4D-6429/Posedion-Project/README.md

# Posedion-Project

Katamaran1
