4D-6429/Posedion-Project/CAD/ORTA_Gövde.STEP

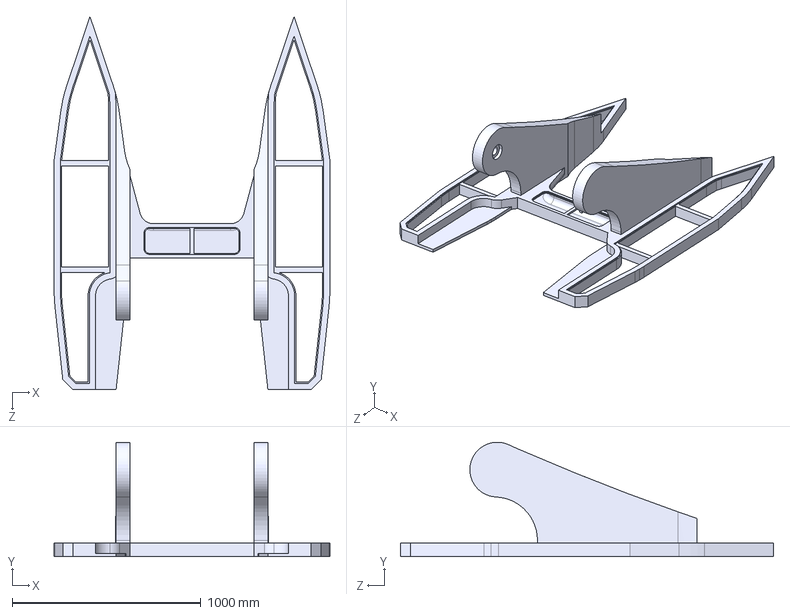
[picture p9: CAD file, 2025-03-03, last stored version]
CAD/ORTA_Gövde.STEP
1460.0 x 606.1 x 1975.0 mm
