4D-6429/Posedion-Project/CAD/Elektro_Kapak.STEP

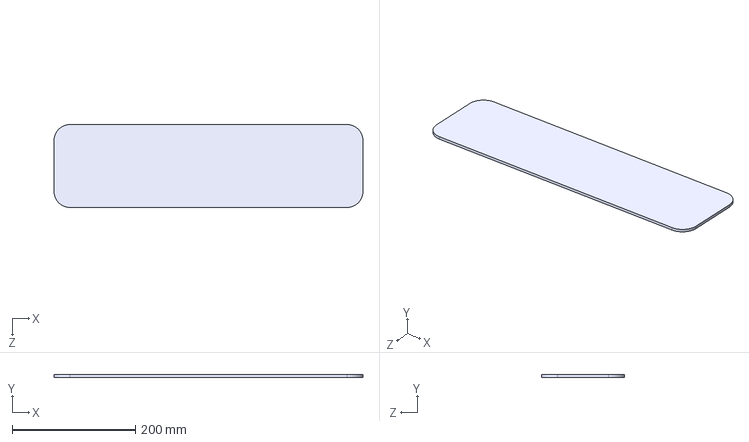
[picture p10: CAD file, 2025-03-03, last stored version]
CAD/Elektro_Kapak.STEP
501.1 x 4.38 x 134.5 mm
