4D-6429/Posedion-Project/CAD/#35 Half Link.STEP

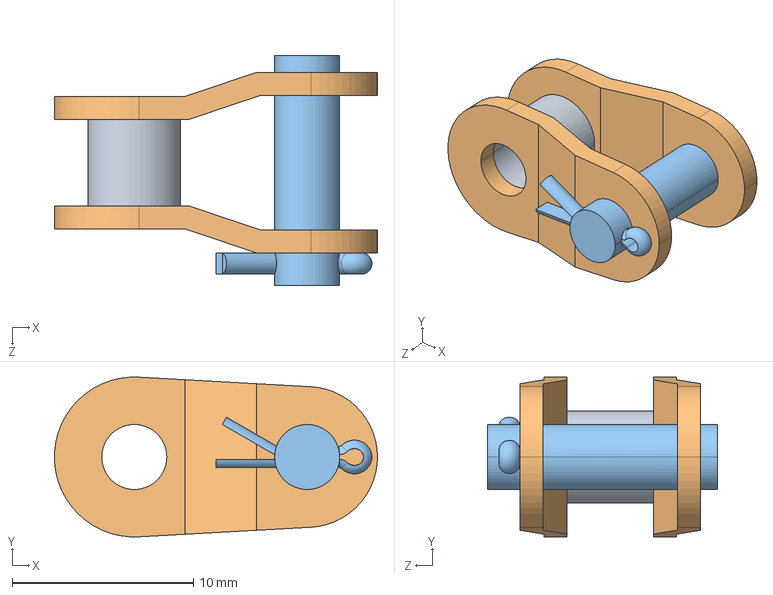
[picture p11: CAD file, 2025-03-03, last stored version]
CAD/#35 Half Link.STEP
17.8 x 8.80 x 12.7 mm
