4D-6429/Posedion-Project/CAD/Kare_Spacer.STEP

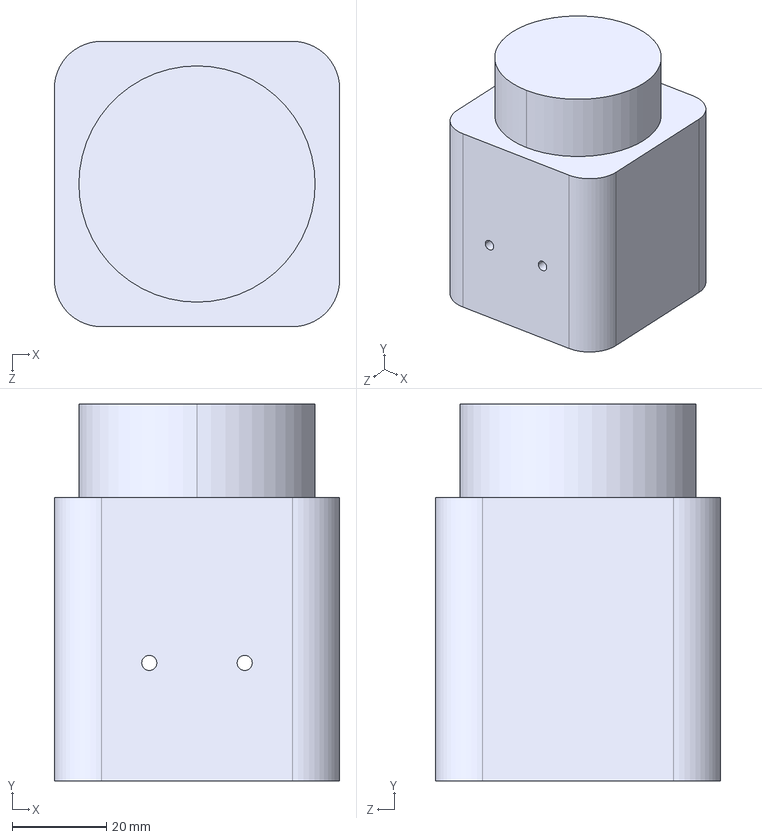
[picture p12: CAD file, 2025-03-03, last stored version]
CAD/Kare_Spacer.STEP
60.4 x 79.8 x 60.4 mm
