4D-6429/Posedion-Project/CAD/24_Torna.STEP

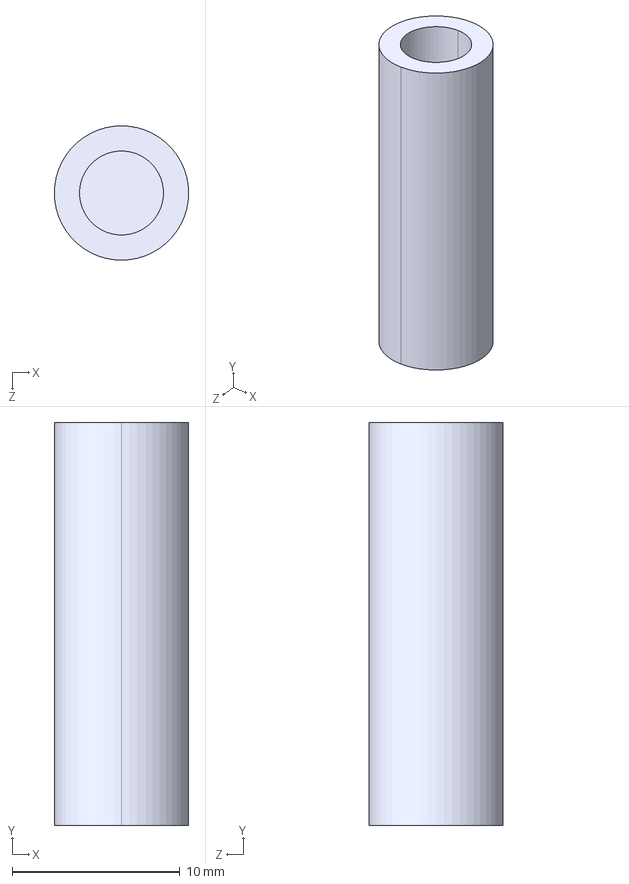
[picture p13: CAD file, 2025-03-03, last stored version]
CAD/24_Torna.STEP
8.00 x 24.0 x 8.00 mm
