4D-6429/Posedion-Project/CAD/Propeller.STEP

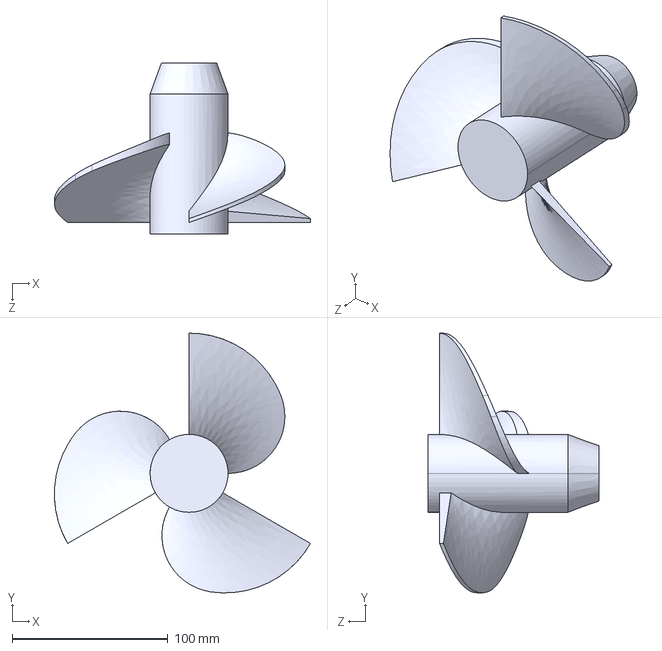
[picture p15: CAD file, 2025-03-03, last stored version]
CAD/Propeller.STEP
164.3 x 166.7 x 110.0 mm
