4D-6429/Posedion-Project/CAD/C-EC254SQ40Z12-POM.STEP

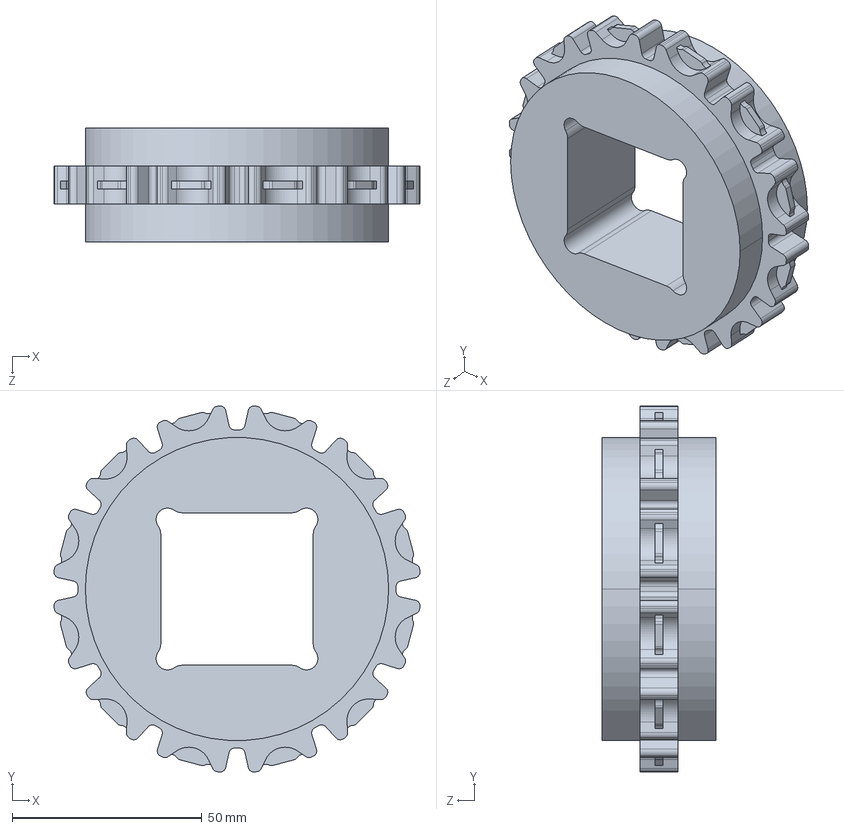
[picture p16: CAD file, 2025-03-03, last stored version]
CAD/C-EC254SQ40Z12-POM.STEP
96.6 x 96.6 x 30.0 mm
