4D-6429/Posedion-Project/CAD/HEX_Şaft-2in.STEP

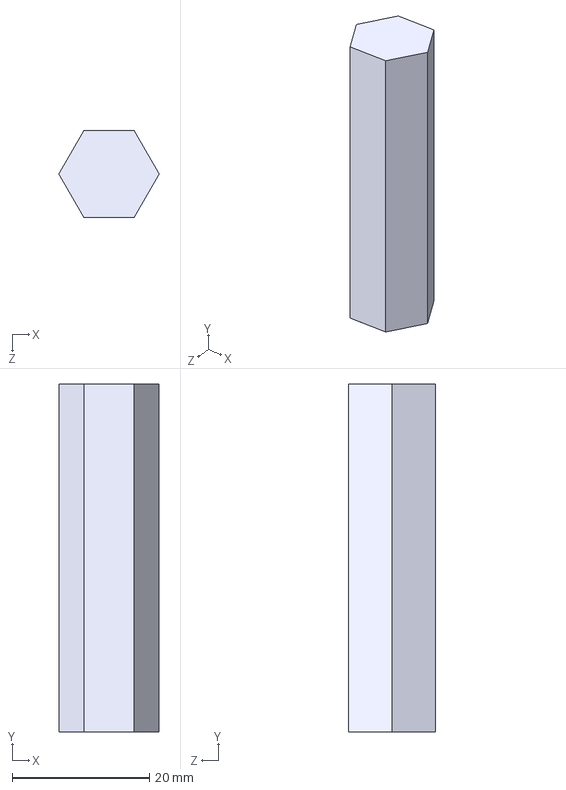
[picture p17: CAD file, 2025-03-03, last stored version]
CAD/HEX_Şaft-2in.STEP
14.7 x 50.8 x 12.7 mm
