4D-6429/Posedion-Project/CAD/Aşağı_Şaft.STEP

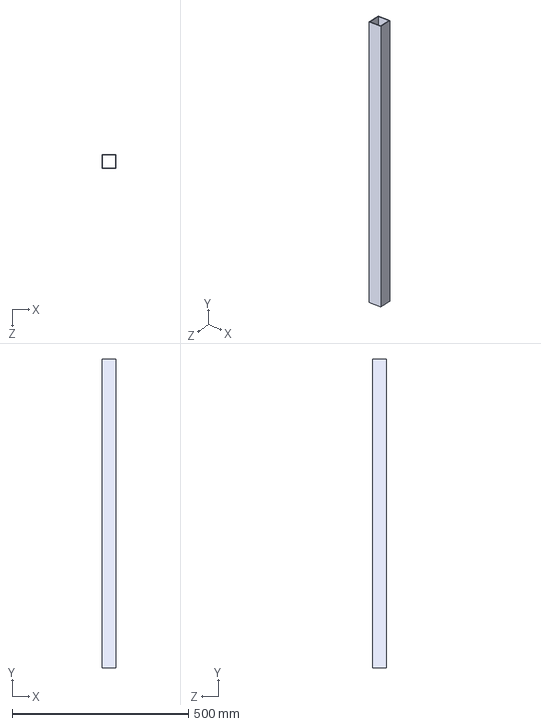
[picture p18: CAD file, 2025-03-03, last stored version]
CAD/Aşağı_Şaft.STEP
40.0 x 875.6 x 40.0 mm
