4D-6429/Posedion-Project/CAD/Kon_Güç.STEP

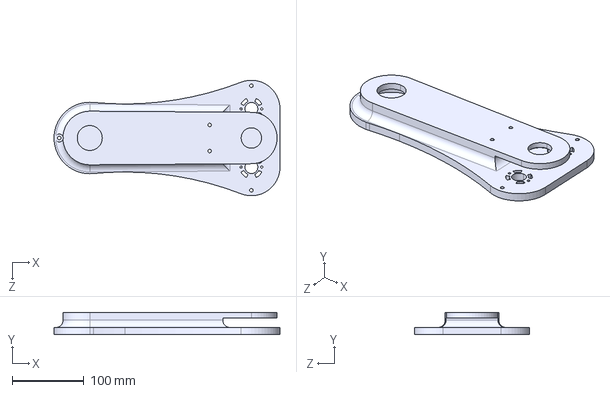
[picture p19: CAD file, 2025-03-03, last stored version]
CAD/Kon_Güç.STEP
316.1 x 30.9 x 161.4 mm
