4D-6429/Posedion-Project/CAD/Kapak.STEP

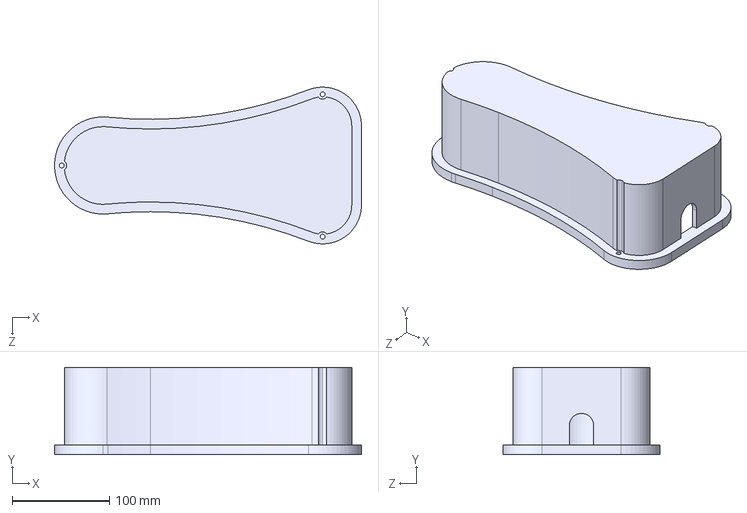
[picture p20: CAD file, 2025-03-03, last stored version]
CAD/Kapak.STEP
316.1 x 90.0 x 161.4 mm
