4D-6429/Posedion-Project/CAD/12t Aluminum Double Hub Sprocket (#35 Chain, 12 Hex Bore).step

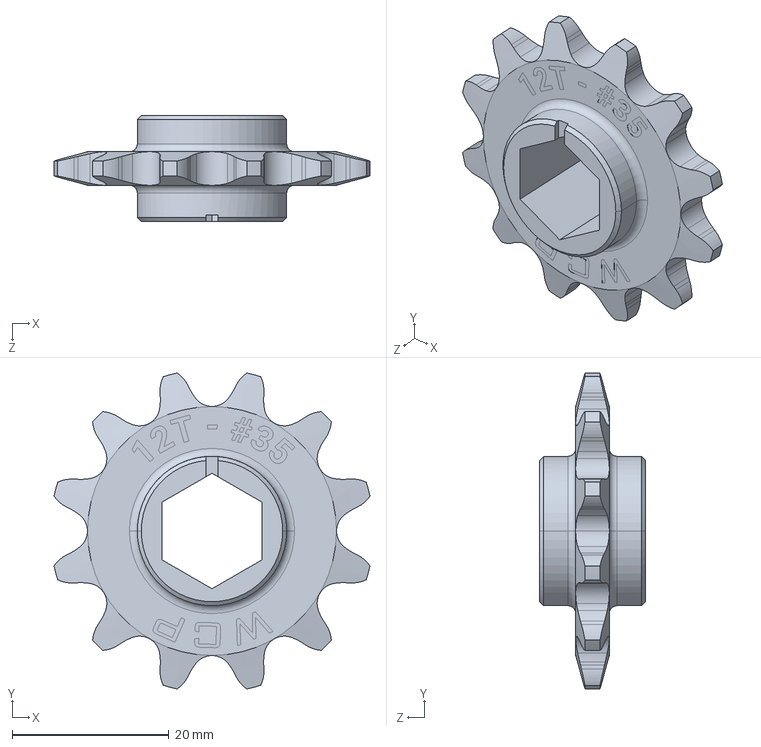
[picture p21: CAD file, 2025-03-03, last stored version]
CAD/12t Aluminum Double Hub Sprocket (#35 Chain, 12 Hex Bore).step
40.3 x 40.3 x 13.5 mm
