4D-6429/Posedion-Project/CAD/Hazne.STEP

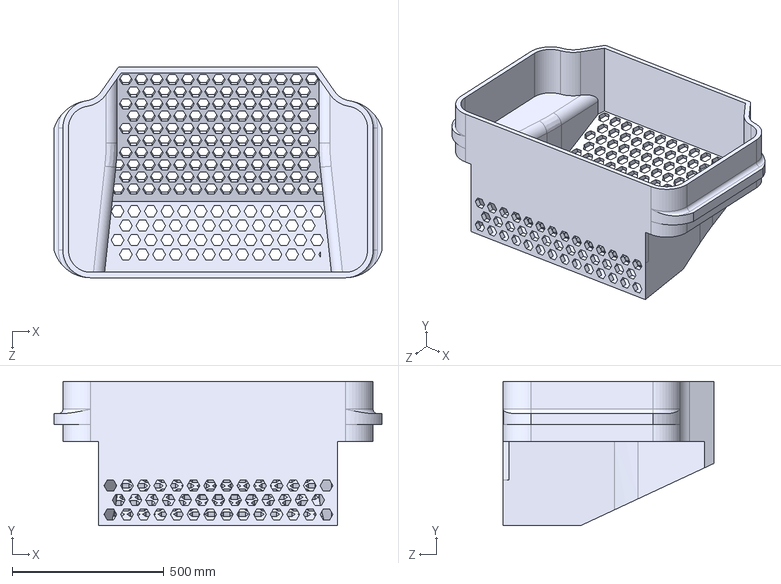
[picture p23: CAD file, 2025-03-03, last stored version]
CAD/Hazne.STEP
1080.4 x 474.5 x 693.5 mm
