4D-6429/Posedion-Project/CAD/PoliÜst.STEP

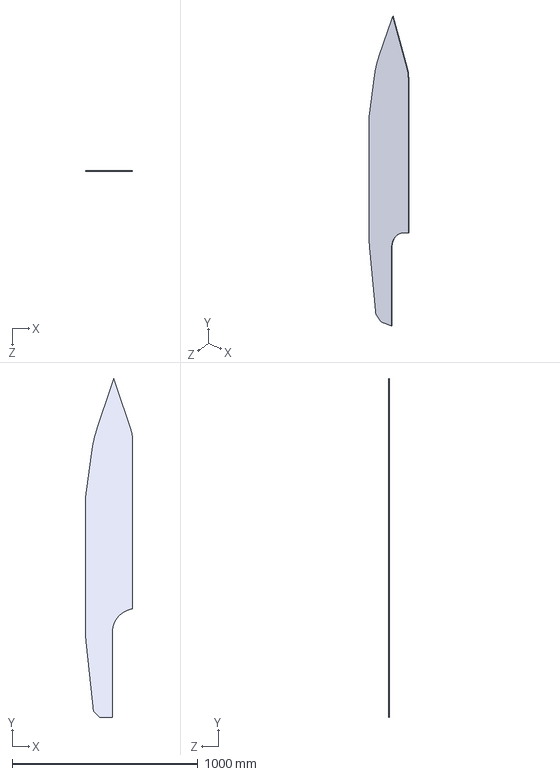
[picture p24: CAD file, 2025-03-03, last stored version]
CAD/PoliÜst.STEP
255.5 x 1824.0 x 4.38 mm
