4D-6429/Posedion-Project/CAD/0.5 hex çark 54t 20dp.STEP

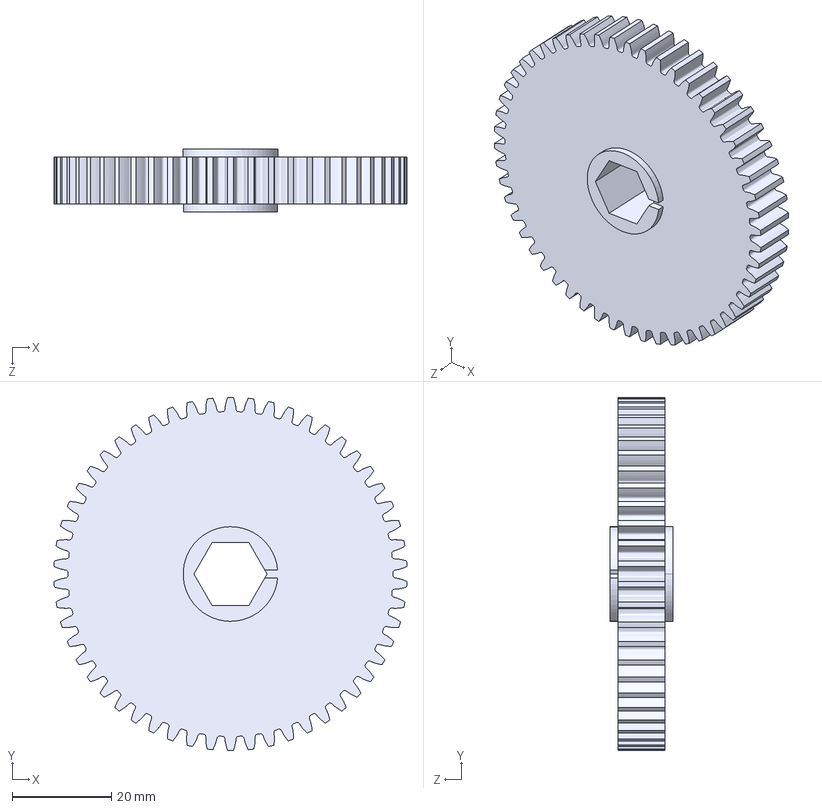
[picture p25: CAD file, 2025-03-03, last stored version]
CAD/0.5 hex çark 54t 20dp.STEP
71.1 x 71.1 x 12.6 mm
