4D-6429/Posedion-Project/CAD/10mmX111cm.STEP

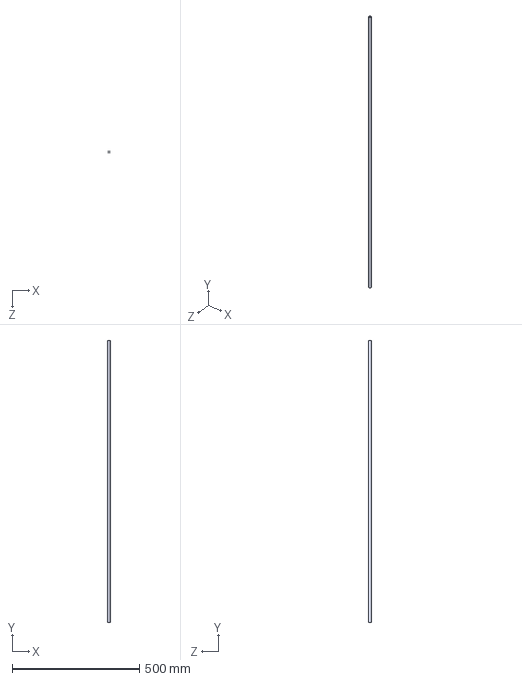
[picture p26: CAD file, 2025-03-03, last stored version]
CAD/10mmX111cm.STEP
10.0 x 1110.0 x 10.0 mm
