4D-6429/Posedion-Project/CAD/0.5 hex rulman.STEP

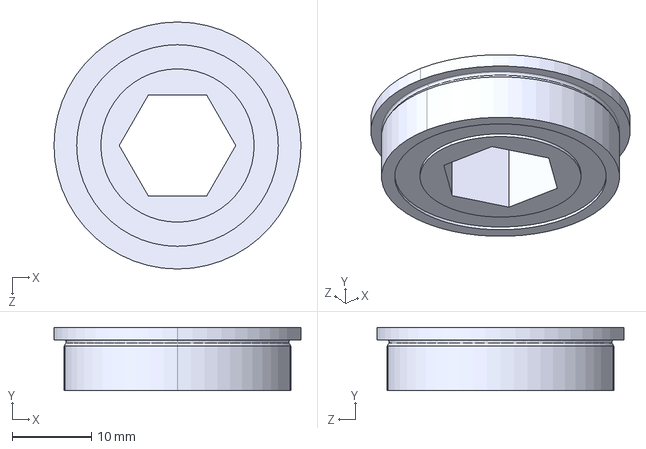
[picture p27: CAD file, 2025-03-03, last stored version]
CAD/0.5 hex rulman.STEP
31.1 x 7.94 x 31.1 mm
