4D-6429/Posedion-Project/CAD/50x90x20_Rulman.STEP

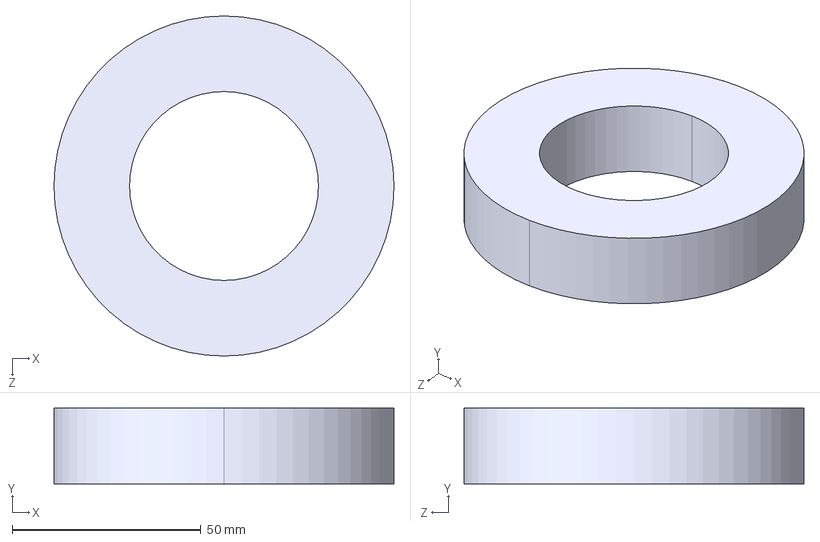
[picture p28: CAD file, 2025-03-03, last stored version]
CAD/50x90x20_Rulman.STEP
90.0 x 20.0 x 90.0 mm
