4D-6429/Posedion-Project/CAD/Spacer_5-19.STEP

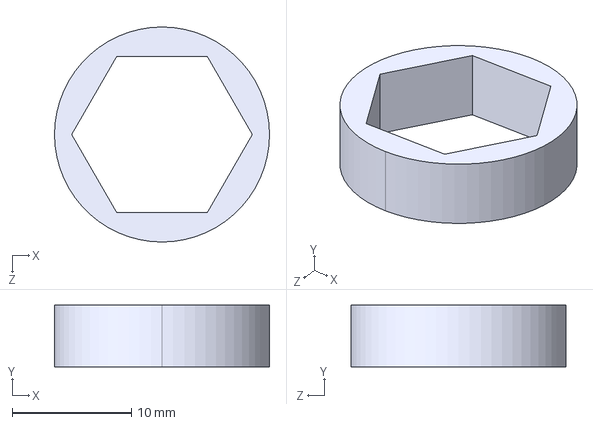
[picture p29: CAD file, 2025-03-03, last stored version]
CAD/Spacer_5-19.STEP
18.0 x 5.19 x 18.0 mm
