4D-6429/Posedion-Project/CAD/#35 Master Link.STEP

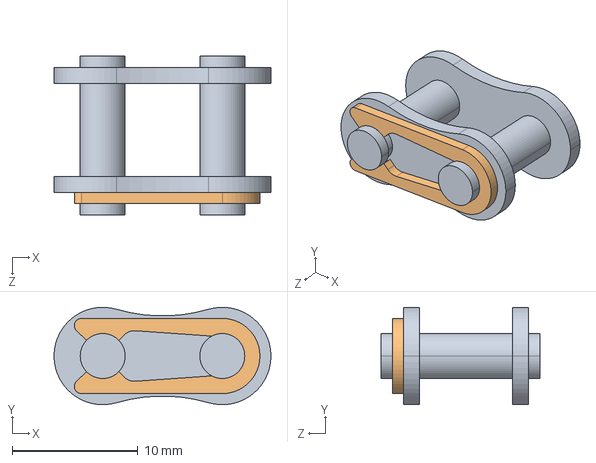
[picture p30: CAD file, 2025-03-03, last stored version]
CAD/#35 Master Link.STEP
17.3 x 7.75 x 12.7 mm
