4D-6429/Posedion-Project/CAD/HEX_Spacer.STEP

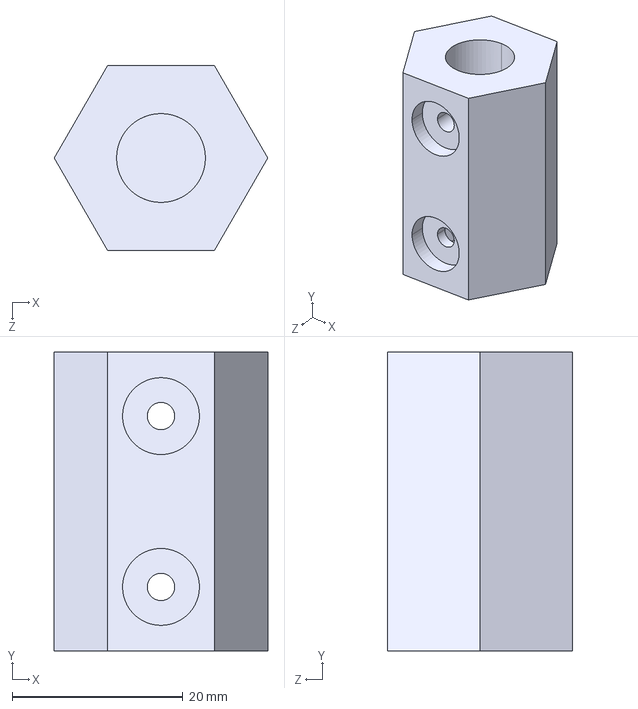
[picture p31: CAD file, 2025-03-03, last stored version]
CAD/HEX_Spacer.STEP
25.0 x 35.0 x 21.7 mm
