4D-6429/Posedion-Project/CAD/775Pinyon 8T.STEP

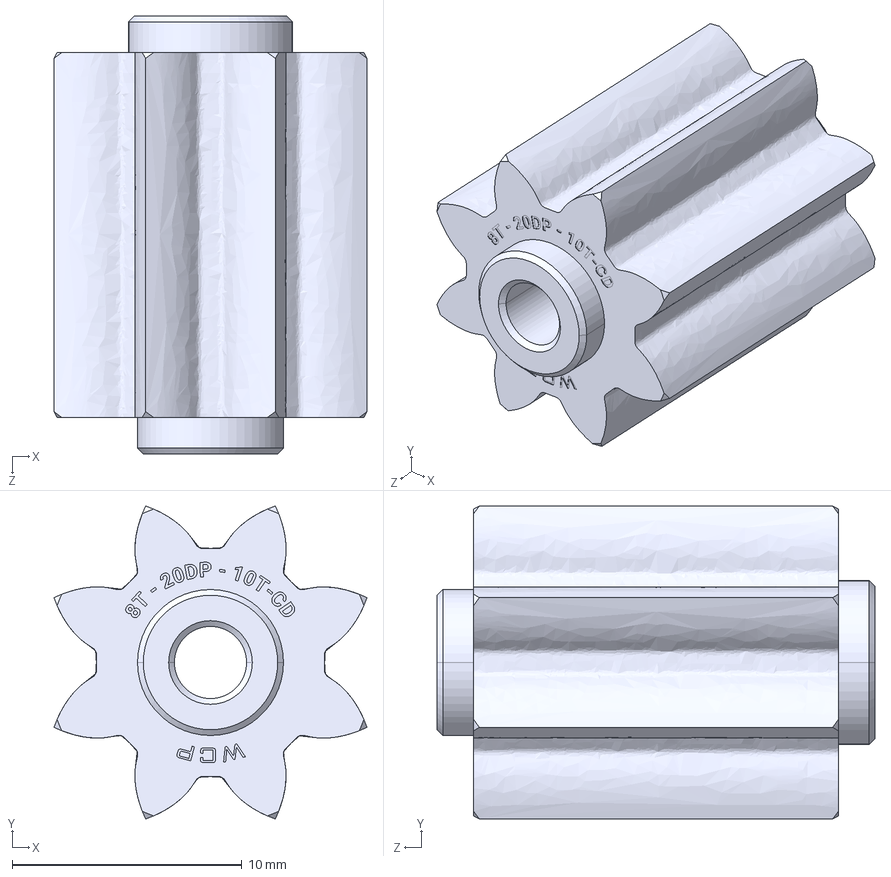
[picture p32: CAD file, 2025-03-03, last stored version]
CAD/775Pinyon 8T.STEP
13.6 x 13.6 x 19.1 mm
