4D-6429/Posedion-Project/CAD/HEX_Şaft-5in.STEP

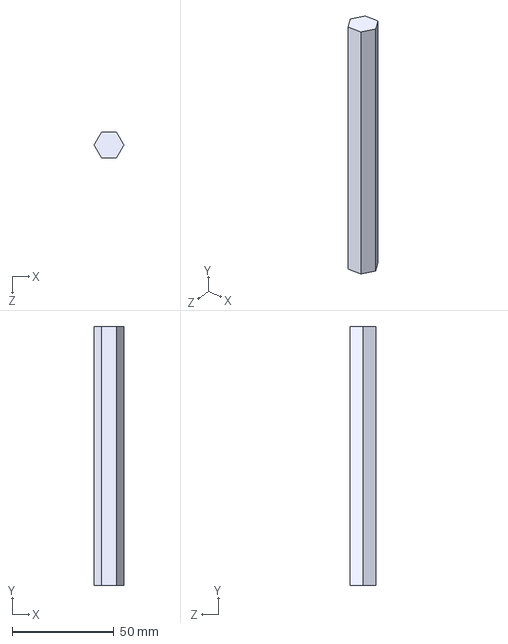
[picture p33: CAD file, 2025-03-03, last stored version]
CAD/HEX_Şaft-5in.STEP
14.7 x 127.0 x 12.7 mm
