4D-6429/Posedion-Project/CAD/84t Aluminum Plate Sprocket (#35 Chain, SplineXL Bore).step

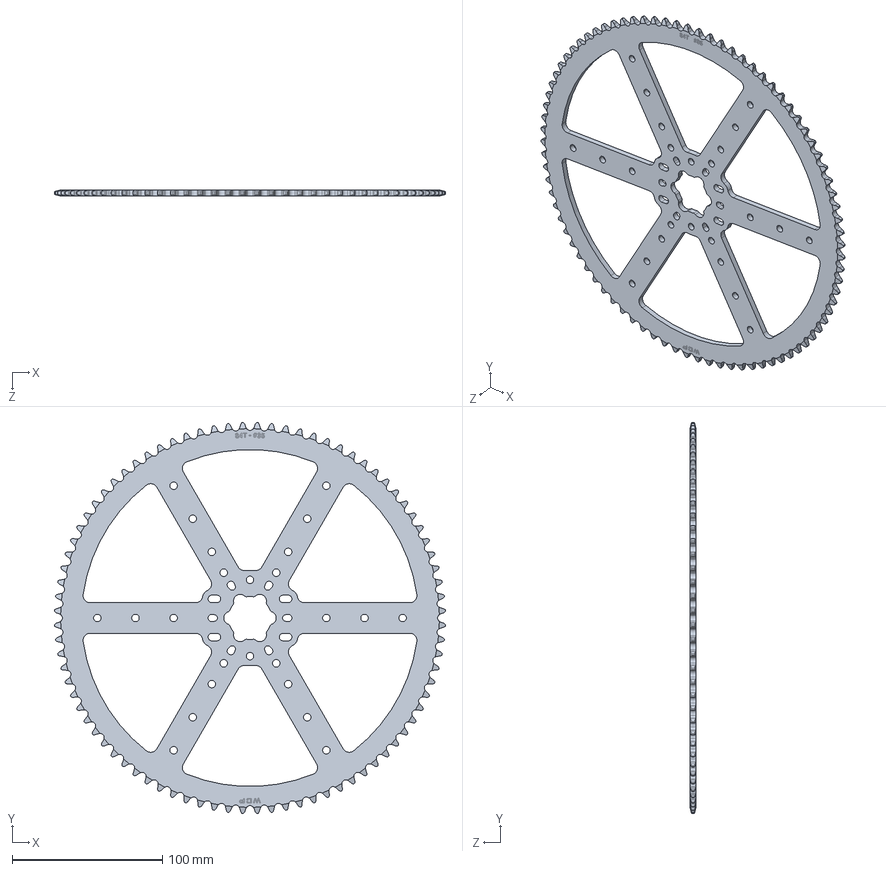
[picture p34: CAD file, 2025-03-03, last stored version]
CAD/84t Aluminum Plate Sprocket (#35 Chain, SplineXL Bore).step
260.1 x 260.1 x 4.00 mm
