4D-6429/Posedion-Project/CAD/Yukarı_Şaft.STEP

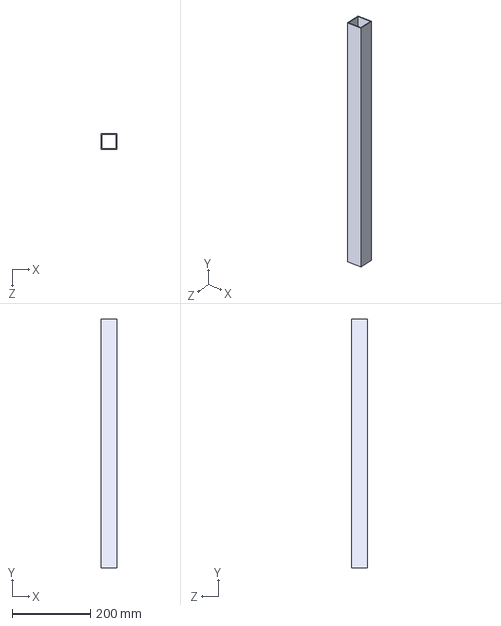
[picture p35: CAD file, 2025-03-03, last stored version]
CAD/Yukarı_Şaft.STEP
40.0 x 637.0 x 40.0 mm
