4D-6429/Posedion-Project/CAD/17x35x10_Rulman.STEP

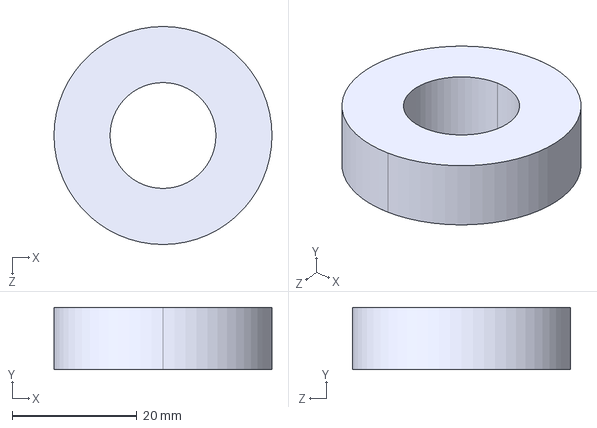
[picture p36: CAD file, 2025-03-03, last stored version]
CAD/17x35x10_Rulman.STEP
35.0 x 10.0 x 35.0 mm
