4D-6429/Posedion-Project/CAD/SOL_Kanat.STEP

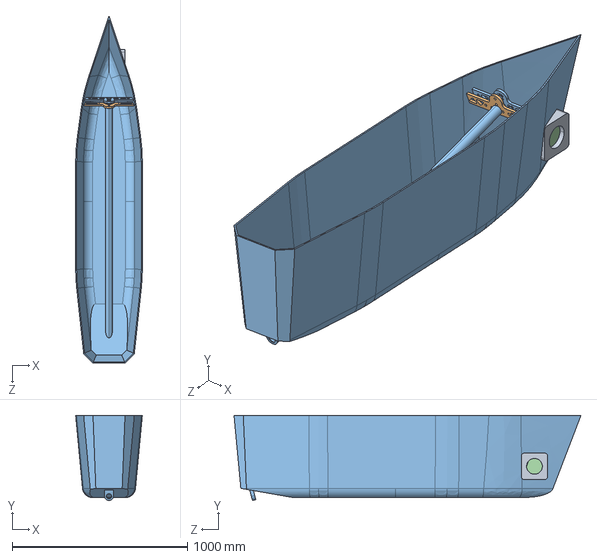
[picture p37: CAD file, 2025-03-03, last stored version]
CAD/SOL_Kanat.STEP
380.3 x 485.0 x 1978.4 mm
