4D-6429/Posedion-Project/CAD/775pro_217-4347.STEP

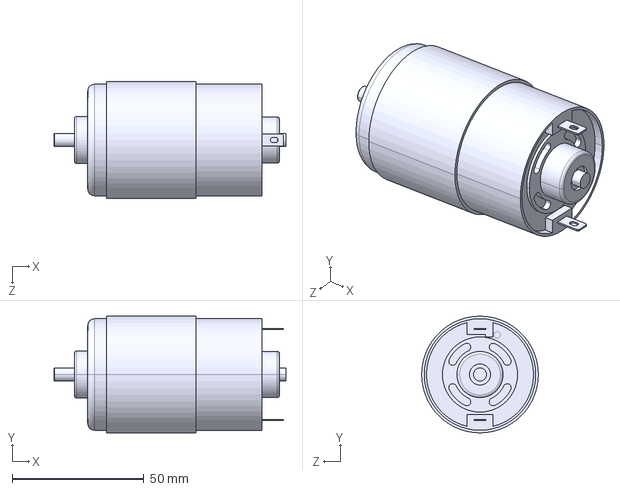
[picture p38: CAD file, 2025-03-03, last stored version]
CAD/775pro_217-4347.STEP
88.0 x 44.3 x 44.3 mm
