4D-6429/Posedion-Project/CAD/Spacer_5-25.STEP

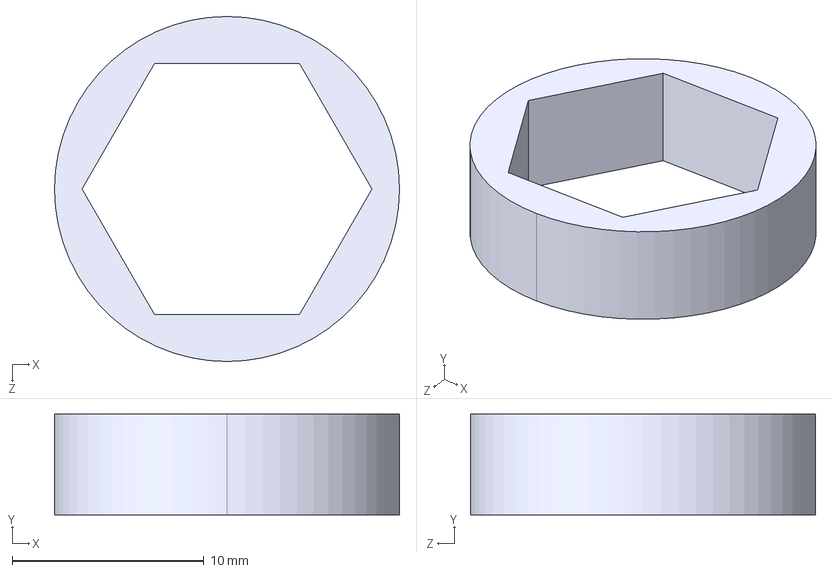
[picture p39: CAD file, 2025-03-03, last stored version]
CAD/Spacer_5-25.STEP
18.0 x 5.25 x 18.0 mm
