4D-6429/Posedion-Project/CAD/Kare_Spacer2.STEP

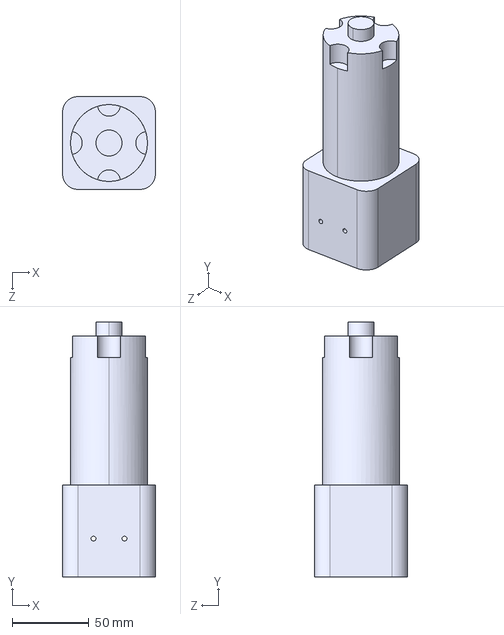
[picture p40: CAD file, 2025-03-03, last stored version]
CAD/Kare_Spacer2.STEP
60.4 x 166.0 x 60.4 mm
