4D-6429/Posedion-Project/CAD/Katamaran.SLDASM

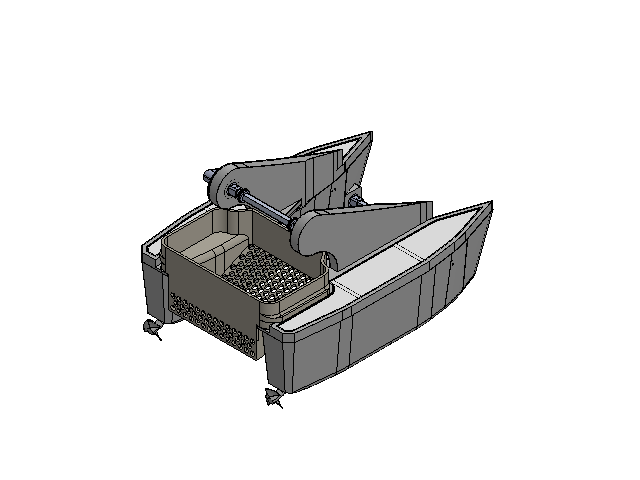
[picture p41: CAD file, 2025-03-03, last stored version]
CAD/Katamaran.SLDASM
ORTA_Gövde
SOL_Kanat
Hazne
SAĞ_Kanat
PoliÜst x 2
0.5 hex rulman x 8
HEX_Şaft-5in x 6
HEX_Spacer x 4
10mmX111cm x 2
0.5 hex çark 54t 20dp x 3
775pro_217-4347 x 8
775Pinyon 8T x 8
HEX-HEX_Spacer x 2
Propeller x 2
50x90x20_Rulman x 4
Kare_Spacer x 3
Yukarı_Şaft
Kare_Spacer2
Aşağı_Şaft
C-EC254SQ40Z12-POM.step x 4
84t Aluminum Plate Sprocket (#35 Chain, SplineXL Bore)
12t Aluminum Double Hub Sprocket (#35 Chain, 12 Hex Bore).step
17x35x10_Rulman
Kon_Güç
HEX_Şaft-2in
Spacer_5-19
Spacer_5-25
Kapak
#35 Half Link x 50
#35 Master Link x 50
24_Torna x 2
Elektro_Kapak
