4D-6429/Posedion-Project/(list of files, cad)

Other CAD files:
CAD/Katamaran.3MF
