4D-6429/Posedion-Project/(commit log)

2025-03-03 CAD Files
    All parts in SolidWorks STEP format.
    [#35 Half Link.STEP, #35 Master Link.STEP, 0.5 hex rulman.STEP, 0.5 hex çark 54t 20dp.STEP, 10mmX111cm.STEP, 12t Aluminum Double Hub Sprocket (#35 Chain, 12 Hex Bore).step, 17x35x10_Rulman.STEP, 24_Torna.STEP]
2025-03-03 CAD upload
    [#35 Half Link.STEP]
2026-06-24 ESP-IDF firmware eklendi, eski Arduino kodu ve CAD dosyaları kaldırıldı
    - Firmware/src/esp32: ESP32-S3 için PlatformIO + ESP-IDF projesi
    - iBUS alıcı (FreeRTOS task, failsafe), MCPWM motor sürücü, kontrol döngüsü
    - MOTOR_LEFT_GPIO=17, MOTOR_RIGHT_GPIO=18 olarak atandı
    - CAD/ ve CODE/ klasörleri repo'dan çıkarıldı
    [#35 Half Link.STEP, #35 Master Link.STEP, 0.5 hex rulman.STEP, 0.5 hex çark 54t 20dp.STEP, 10mmX111cm.STEP, 12t Aluminum Double Hub Sprocket (#35 Chain, 12 Hex Bore).step, 17x35x10_Rulman.STEP, 24_Torna.STEP]
2026-06-24 Cad, Docs, Firmware/Schemes klasörleri eklendi
2026-06-24 Docs/Devices cihaz dökümanları eklendi
2026-06-24 Docs: cihaz dökümanları düzeltildi ve Photos eklendi
    - Yazım hataları düzeltildi (Utras → Ultras)
    - 12 AWG → 10 AWG güncellendi
    - ESP32 pin planı kesinleşti (GPIO16/17/18)
    - Kırık linkler düzeltildi
    - FlySky bind plug açıklaması düzeltildi
    - Güç zinciri tutarsızlığı giderildi
    - Photos klasörü eklendi (jpeg formatında)
2026-06-24 Docs/Devices: tüm cihaz dökümanları yeniden formatlandı
    - YAML frontmatter eklendi (part, category, price_tl, status)
    - Sabit bölüm sırası: özet → teknik → bağlantı → uyarılar
    - Fotoğraflar ilgili dosyalara entegre edildi
    - Güç zinciri diyagramları ve yük tabloları eklendi
    - Teknik detaylar zenginleştirildi
2026-10-03 Firmware/esp32: ESC kalibrasyon modu ve sol motor trim telafisi eklendi
    - motor.c/h: motor_calibrate_escs() eklendi (MAX -> NOTR sinyal dizisi, ESC arm/kalibrasyon icin); main.c'deki ESC_CALIBRATION_MODE flag'i ile tetikleniyor
    - motor.c: to_pulse_us() trim parametresi aliyor; MOTOR_LEFT_TRIM_US (-13us) ile sol ESC'nin kaymis notr noktasi telafi ediliyor
    - motor.c: motor_set() her cagrida ESC pulse genisliklerini loglar (diagnostik)
    - control.h: deadzone/throttle/yaw limitleri guvenli test icin dusuruldu (0.05->0.01, 0.80->0.10, 0.70->0.07) ve ramp rate gecici olarak devre disi birakildi (2.0f, tek dongude hedefe atlar)
    - sdkconfig: flash boyutu 2MB -> 16MB olarak duzeltildi (gercek donaniml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
